xbst/Hedgehog/Gerbers/BOM.xlsx

No. | Quantity | Comment | Designator | Footprint | Value | Manufacturer Part | Manufacturer
1 | 2 | EVPAA202K | BOOT,RESET | KEY-SMD_4P-L3.5-W2.9-P1.48-LS4.3-TL |  | EVPAA202K | PANASONIC(松下)
2 | 8 | 100nF | C1,C2,C3,C4,C5,C13,C14,C15 | C0402 | 100nF | CL05B104KB54PNC | SAMSUNG(三星)
3 | 1 | 10uF | C6 | CAP-SMD_L3.2-W1.6-RD | 10uF | TAJA106K016RNJ | Kyocera AVX
4 | 1 | 1uF | C7 | CAP-SMD_L3.2-W1.6-RD | 1uF | TAJA105K035RNJ | Kyocera AVX
5 | 1 | SS24L | D1 | SOD-123FL_L2.8-W1.8-LS3.7-R-RD |  | SS24L | Hottech(合科泰)
6 | 1 | USBLC6-2SC6 | D2 | SOT-23-6_L2.9-W1.6-P0.95-LS2.8-BL |  | USBLC6-2SC6 | TECH PUBLIC(台舟)
7 | 3 | BAV99,215 | D3,D4,D5 | SOT-23-3_L2.9-W1.6-P1.90-LS2.8-BR |  | BAV99,215 | Nexperia(安世)
8 | 2 | TSW-116-07-L-T | H1,H2 | HDR-TH_48P-P2.54-V-M-R3-C16-S2.54_1 |  | TSW-116-07-L-T | SAMTEC
9 | 2 | 19-217/BHC-ZL1M2RY/3T | MCU,PWR | LED0603-FD_BLUE |  | 19-217/BHC-ZL1M2RY/3T | EVERLIGHT(亿光)
10 | 1 | 120Ω | R1 | R0805 | 120Ω | ERJP06F1200V | PANASONIC(松下)
11 | 2 | 5.1kΩ | R2,R3 | R0402 | 5.1kΩ | 0402WGF5101TCE | UNI-ROYAL(厚声)
12 | 2 | 1.5kΩ | R4,R5 | R0402 | 1.5kΩ | 0402WGF1501TCE | UNI-ROYAL(厚声)
13 | 1 | 10kΩ | R6 | R0402 | 10kΩ | 0402WGF1002TCE | UNI-ROYAL(厚声)
14 | 6 | 2.37kΩ | R7,R8,R10,R11,R13,R14 | R0402 | 2.37kΩ | RC0402FR-072K37L | YAGEO(国巨)
15 | 3 | 4.7kΩ | R9,R12,R15 | R0402 | 4.7kΩ | 0402WGF4701TCE | UNI-ROYAL(厚声)
16 | 1 | TCAN3414DDFR | U1 | TSOT-23-8_L2.9-W1.6-P0.65-LS2.8-BR |  | TCAN3414DDFR | TI(德州仪器)
17 | 1 | STM32G0B1CBT6 | U2 | LQFP-48_L7.0-W7.0-P0.50-LS9.0-BL |  | STM32G0B1CBT6 | ST(意法半导体)
18 | 1 | AP7375-33Y-13 | U3 | SOT-89-3_L4.5-W2.5-P1.50-LS4.0-BR |  | AP7375-33Y-13 | DIODES(美台)
19 | 1 | 918-418K2023S40001 | USBC | USB-C-SMD_TYPE-C-USB-17 |  | 918-418K2023S40001 | 精拓金
20 | 1 | 430450401 | VIN | CONN-TH_0430450400 |  | 430450401 | MOLEX
21 | 1 | 8MHz | X1 | OSC-SMD_4P-L2.5-W2.0-BL | 8MHz | SG-210STF 8.0000ML0 | EPSON
