xbst/Hedgehog/Gerbers/Schematic.pdf

# TRANSCEIVER

IO

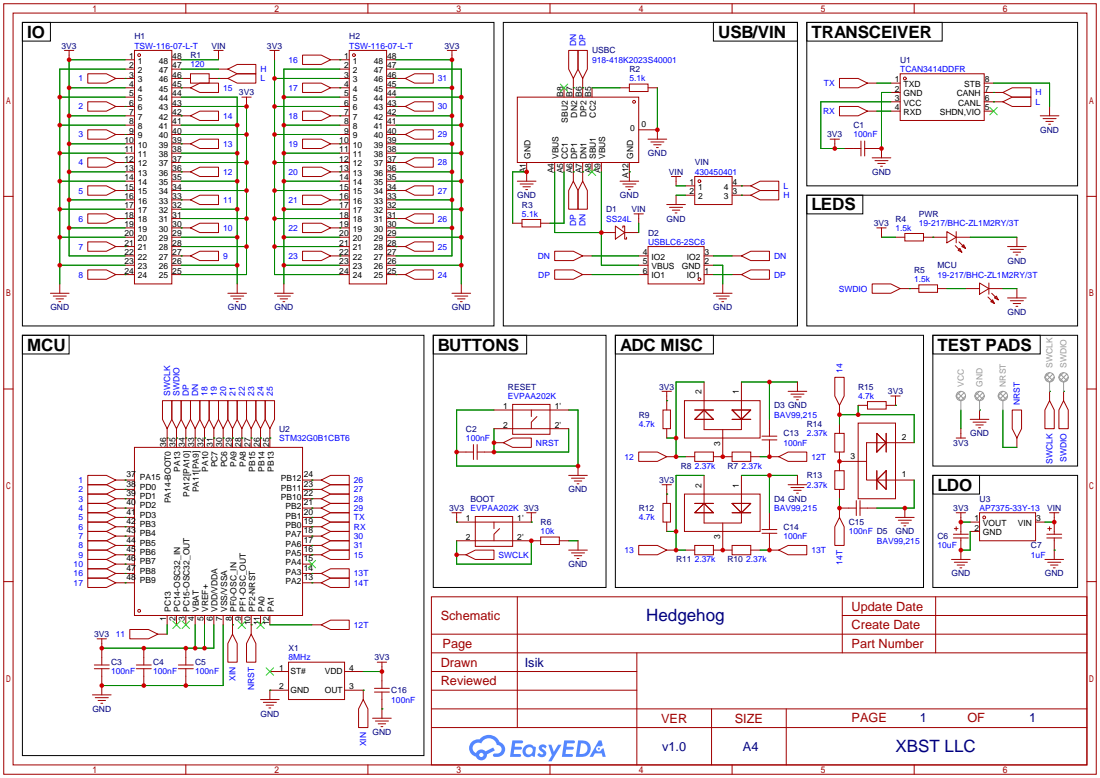
[picture p2: page 1]
