xbst/Hedgehog/(list of files, drawings)

Other design files:
Source/Hedgehog.epro
